zhgary/UCLA_EE180D_Robot/README.md

UCLA_EE180D_Robot

For best results, read tutorials in order.
