zhgary/UCLA_EE180D_Robot/CAD/receiver mount.stl

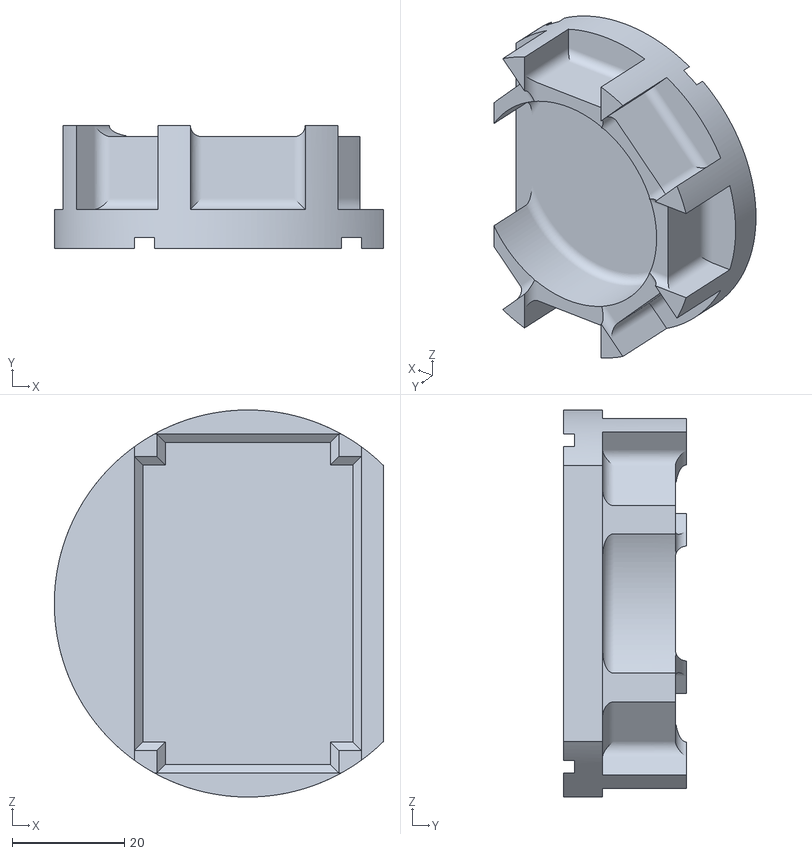
[picture p6: CAD file, 2016-06-24]
CAD/receiver mount.stl
58.8 x 22.0 x 69.1
