zhgary/UCLA_EE180D_Robot/CAD/distance sensor mount_2.stl

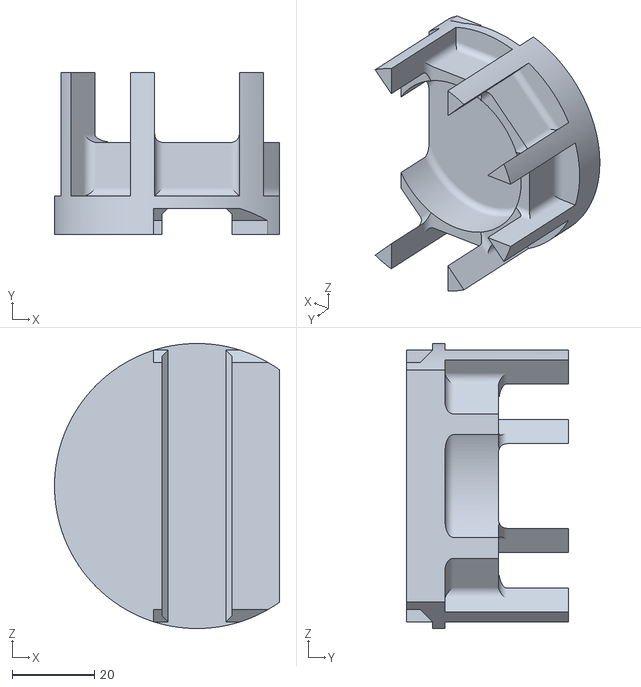
[picture p7: CAD file, 2016-06-24]
CAD/distance sensor mount_2.stl
54.6 x 39.4 x 69.1
