zhgary/UCLA_EE180D_Robot/(list of files, cad)

Other CAD files:
CAD/distance sensor mount_2.ipt
CAD/receiver mount.ipt
