zhgary/UCLA_EE180D_Robot/(commit log)

2016-06-24 Distance sensor array
    [distance sensor mount_2.ipt, distance sensor mount_2.stl, receiver mount.ipt, receiver mount.stl]
2016-06-24 Parallelism UART tutorial
